AnonymousCandela/surveillance-moteur-fpga/Calibration_GEN5001_ordonnee (1).xlsx

Sheet: Lisez-moi
Campagne de calibration — banc de charge par génératrice
Stage GEN5001 · Bekobo Nguedi Ariel Toussaint · UQO
Contenu du classeur
Données brutes — les dix séries d'origine, remises en colonnes appariées par palier.
Séries établies — mêmes séries après retrait de la phase de démarrage.
Synthèse — moyenne, écart-type et plage ±2σ par palier (formules Excel).
Dérive — évolution du courant au cours de chaque acquisition.
Règle de sélection appliquée
Chaque série d'origine contient une phase de démarrage (valeurs nulles moteur à l'arrêt, puis
montée en régime). Cette phase a été retirée de façon uniforme : on écarte les valeurs nulles,
puis tous les échantillons antérieurs au premier qui atteint 95 % de la médiane des cent
derniers échantillons de la série. Le reste constitue la période établie.
Cette règle unique remplace la sélection manuelle de fenêtres, qui variait d'une série à
l'autre dans le fichier d'origine et produisait des moyennes non comparables entre paliers.
Unités
Vitesse en tours par minute (tr/min). Courant converti en milliampères (les données
d'origine étaient en ampères). Cadence d'acquisition : 10 Hz, soit 600 échantillons par minute.
Point d'attention
Le courant dérive au cours de plusieurs acquisitions (voir l'onglet Dérive). Les moyennes de
courant dépendent donc de la fenêtre retenue, ce qui n'est pas le cas de la vitesse.

Sheet: Données brutes
Séries d'origine, réorganisées par palier (courant converti en mA)
P1 — Circuit ouvert |  | P2 — 220 Ω |  | P3 — 100 Ω |  | P4 — 51 Ω |  | P5 — 33,33 Ω
Vitesse (tr/min) | Courant (mA) | Vitesse (tr/min) | Courant (mA) | Vitesse (tr/min) | Courant (mA) | Vitesse (tr/min) | Courant (mA) | Vitesse (tr/min) | Courant (mA)
0 | 0 | 157.5 | 500 | 110 | 500 | 76.6 | 400 | 58.2 | 400
0 | 0 | 158.8 | 500 | 109.6 | 500 | 76.6 | 400 | 58.6 | 400
0 | 0 | 159.7 | 500 | 109.2 | 500 | 77.1 | 500 | 59.1 | 400
0 | 0 | 157.5 | 500 | 110.4 | 500 | 75.8 | 400 | 58.6 | 400
0 | 0 | 159.7 | 500 | 110.9 | 500 | 77.1 | 300 | 58.6 | 400
0 | 0 | 158.4 | 500 | 110 | 600 | 76.6 | 400 | 59.1 | 600
0 | 0 | 158 | 500 | 110.4 | 500 | 76.2 | 500 | 58.2 | 200
0 | 0 | 159.7 | 500 | 110.4 | 500 | 77.1 | 300 | 58.6 | 400
0 | 0 | 158.8 | 500 | 109.2 | 500 | 76.6 | 400 | 58.2 | 400
0 | 0 | 157.5 | 500 | 111.3 | 600 | 76.2 | 500 | 58.2 | 500
0 | 0 | 159.7 | 500 | 109.8 | 500 | 76.2 | 400 | 59.1 | 300
0 | 0 | 158.1 | 500 | 111.3 | 600 | 76.6 | 500 | 58.6 | 400
0 | 0 | 158.4 | 500 | 110.4 | 500 | 75.8 | 200 | 58.6 | 500
0 | 0 | 160.1 | 600 | 110 | 500 | 77.1 | 400 | 59.1 | 500
0 | 0 | 157.5 | 500 | 111.3 | 500 | 75.8 | 400 | 58.6 | 400
0 | 0 | 159.7 | 500 | 111.7 | 500 | 77.1 | 400 | 58.6 | 700
0 | 0 | 159.2 | 600 | 110 | 500 | 77.1 | 300 | 58.6 | 600
0 | 0 | 158 | 600 | 111.7 | 600 | 75.8 | 400 | 58.2 | 700
0 | 600 | 159.7 | 500 | 111.3 | 500 | 76.6 | 400 | 58.6 | 700
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
233.7 | 500 | 160.1 |  |  |  | 74.1 |  | 57.4
229.9 | 600 | 161 |  |  |  | 75.3 |  | 57.8
233.3 | 500 | 161 |  |  |  | 75.3 |  | 57.8
232.9 | 500 | 160.1 |  |  |  | 74.1 |  | 57.4
230.3 | 600 | 161 |  |  |  | 75.3 |  | 57.8
232.9 | 600 | 161 |  |  |  | 74.9 |  | 57.4
232.4 | 500

Sheet: Séries établies
Séries après retrait de la phase de démarrage (règle décrite dans « Lisez-moi »)
P1 — Circuit ouvert |  | P2 — 220 Ω |  | P3 — 100 Ω |  | P4 — 51 Ω |  | P5 — 33,33 Ω
Vitesse (tr/min) | Courant (mA) | Vitesse (tr/min) | Courant (mA) | Vitesse (tr/min) | Courant (mA) | Vitesse (tr/min) | Courant (mA) | Vitesse (tr/min) | Courant (mA)
220.5 | 600 | 157.5 | 600 | 110 | 500 | 76.6 | 500 | 58.2 | 700
219.6 | 500 | 158.8 | 500 | 109.6 | 500 | 76.6 | 400 | 58.6 | 600
218.8 | 500 | 159.7 | 500 | 109.2 | 500 | 77.1 | 300 | 59.1 | 700
220.9 | 600 | 157.5 | 600 | 110.4 | 500 | 75.8 | 400 | 58.6 | 700
220 | 500 | 159.7 | 600 | 110.9 | 500 | 77.1 | 500 | 58.6 | 700
219.2 | 500 | 158.4 | 500 | 110 | 600 | 76.6 | 300 | 59.1 | 500
220.5 | 500 | 158 | 600 | 110.4 | 500 | 76.2 | 400 | 58.2 | 200
220.9 | 500 | 159.7 | 500 | 110.4 | 500 | 77.1 | 500 | 58.6 | 300
219.2 | 600 | 158.8 | 600 | 109.2 | 500 | 76.6 | 400 | 58.2 | 200
221.3 | 500 | 157.5 | 600 | 111.3 | 600 | 76.2 | 500 | 58.2 | 600
222.2 | 500 | 159.7 | 600 | 109.8 | 500 | 76.2 | 200 | 59.1 | 700
219.2 | 600 | 158.1 | 600 | 111.3 | 600 | 76.6 | 400 | 58.6 | 400
221.3 | 500 | 158.4 | 500 | 110.4 | 500 | 75.8 | 400 | 58.6 | 500
220 | 500 | 160.1 | 600 | 110 | 500 | 77.1 | 400 | 59.1 | 500
221.7 | 500 | 157.5 | 600 | 111.3 | 500 | 75.8 | 300 | 58.6 | 500
221.7 | 500 | 159.7 | 600 | 111.7 | 500 | 77.1 | 400 | 58.6 | 700
220.5 | 600 | 159.2 | 500 | 110 | 500 | 77.1 | 400 | 58.6 | 400
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
 |  | 160.5 |  |  |  | 74.9 |  | 58.2
 |  | 161.4 |  |  |  | 74.9 |  | 58.2
 |  | 160.1 |  |  |  | 74.1 |  | 57.4
 |  | 161 |  |  |  | 75.3 |  | 57.8
 |  | 161 |  |  |  | 75.3 |  | 57.8
 |  | 160.1 |  |  |  | 74.1 |  | 57.4
 |  | 161 |  |  |  | 75.3 |  | 57.8
 |  | 161 |  |  |  | 74.9 |  | 57.4

Sheet: Synthèse
Synthèse statistique par palier
Calculée par formules sur l'onglet « Séries établies ». Écart-type sur échantillon (correction de Bessel).
Palier | Charge | R (Ω) | n vitesse | Vitesse moy. (tr/min) | σ vitesse | Plage ±2σ vitesse | n courant | Courant moy. (mA) | σ courant | Plage ±2σ courant
P1 | Circuit ouvert | — | 415 | 227.5 | 3.13 | 221.3 – 233.8 | 582 | 532.6460481 | 47.3 | 438 – 627
P2 | 220 Ω | 220 | 599 | 159.5 | 1.08 | 157.3 – 161.7 | 569 | 534.4463972 | 96.8 | 341 – 728
P3 | 100 Ω | 100 | 540 | 112.2 | 0.79 | 110.6 – 113.8 | 573 | 508.2024433 | 27.5 | 453 – 563
P4 | 51 Ω | 51 | 599 | 75.4 | 0.63 | 74.2 – 76.7 | 556 | 510.0719424 | 63.6 | 383 – 637
P5 | 33,33 Ω | 33.33 | 599 | 58.1 | 0.48 | 57.2 – 59.1 | 554 | 564.0794224 | 150.6 | 263 – 865
Lecture
La vitesse décroît de façon strictement monotone quand la résistance de charge diminue, et les plages ±2σ des cinq paliers sont disjointes :
la vitesse discrimine sans ambiguïté les cinq niveaux de charge.
Le courant, lui, ne varie pas de façon monotone et les plages ±2σ des cinq paliers se recouvrent toutes. Avec cette acquisition, le courant seul
ne permet donc pas de distinguer les niveaux de charge. Voir l'onglet « Dérive » pour l'explication probable.

Sheet: Dérive
Dérive du courant au cours de chaque acquisition
Moyenne du courant (mA) calculée par tranches successives de 60 échantillons, soit 6 secondes à 10 Hz.
Tranche | P1 (Circuit ouvert) | P2 (220 Ω) | P3 (100 Ω) | P4 (51 Ω) | P5 (33,33 Ω)
0–6 s | 525 | 495 | 512 | 428 | 575
6–12 s | 545 | 413 | 508 | 503 | 572
12–18 s | 548 | 427 | 507 | 515 | 540
18–24 s | 537 | 480 | 503 | 493 | 508
24–30 s | 528 | 535 | 502 | 495 | 528
30–36 s | 527 | 550 | 513 | 538 | 415
36–42 s | 525 | 600 | 508 | 550 | 590
42–48 s | 535 | 618 | 510 | 523 | 630
48–54 s | 532 | 632 | 512 | 542 | 680
54–60 s | 521 | 659 | 506 | 519 | 729
Pente (mA/min) | -13.2 | 263.5 | 1 | 99.1 | 122.4
Une pente marquée signifie que la moyenne du courant dépend de la fenêtre d'acquisition retenue, ce qui rend
les paliers non comparables entre eux. Les cases orangées signalent une dérive supérieure à 50 mA/min.
