AnonymousCandela/surveillance-moteur-fpga/(commit log)

2026-10-16 Ajoute le firmware Arduino Mega 2560 (acquisition, régulation, UART)
2026-10-16 Ajoute les données de la campagne de calibration
    [Calibration_GEN5001_ordonnee (1).xlsx]
2026-10-16 Ajoute le rapport final de stage GEN5001
2026-10-16 Ajoute le README de présentation du projet
2026-10-16 Ajoute une copie lisible des sources VHDL et des fichiers Quartus
2026-10-16 Met à jour le README avec les liens vers les sources VHDL
